Kotdnz/induction_anneal/media/images/cooling_fan.png

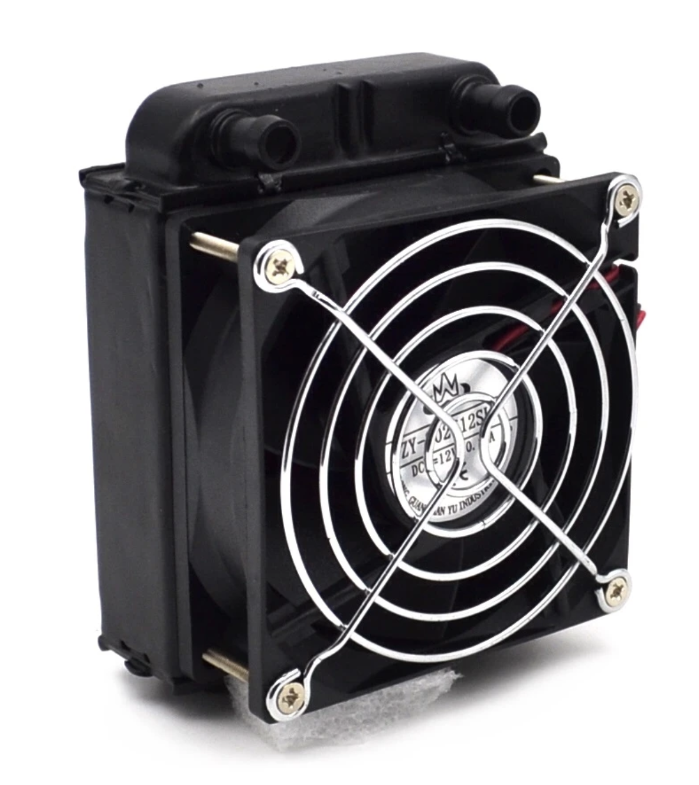
media/images/cooling_fan.png
