Kotdnz/induction_anneal/media/images/main_concept.jpg

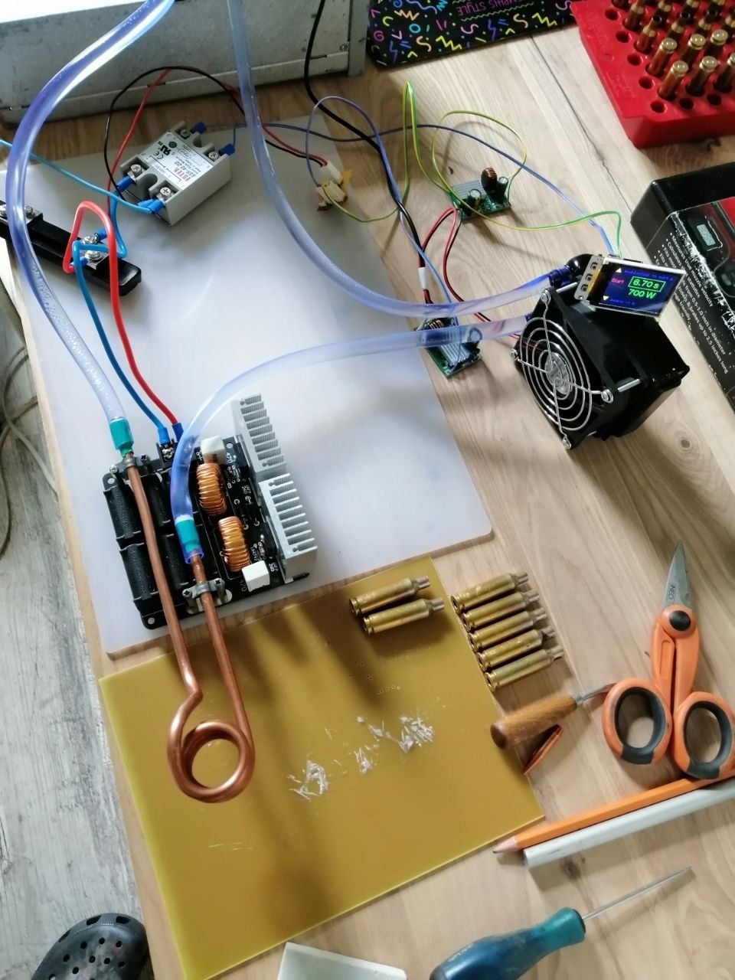
media/images/main_concept.jpg
