Kotdnz/induction_anneal/media/images/power_supply.jpg

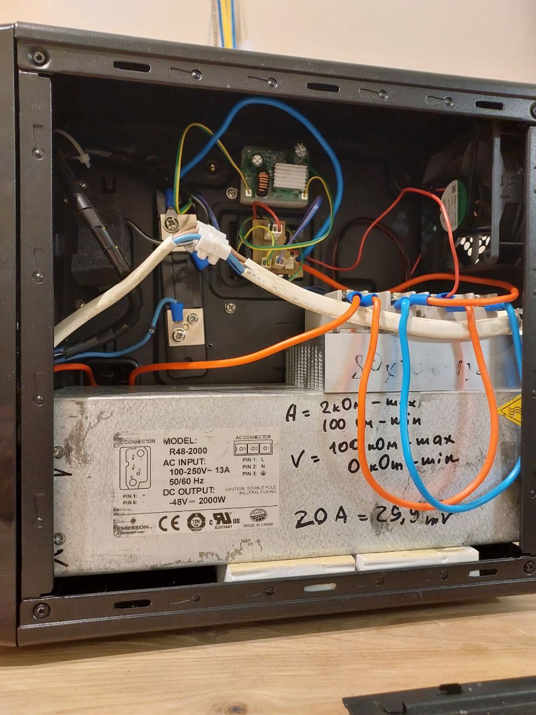
media/images/power_supply.jpg
