Kotdnz/induction_anneal/BOM.xlsx

 | кол-во | грн
Однофазне твердотільне реле SSR-40DD 40А DC-DC - сгорел! - беру 100а | 1 | 150 | https://prom.ua/ua/p1333096980-odnofaznoe-tverdotelnoe-rele.html?
ZVS 20A, 1000Вт вихровий індукційний нагрівач. Живлення 12-48В | 1 | 1000 | https://collider.prom.ua/ua/p884756762-zvs-20a-1000vt.html
Блок живлення Emerson R48-1800 з регулюванням 30-60В(35А) і вольтметром | 1 | 1150 | https://prom.ua/ua/p804608163-blok-pitaniya-emerson.html?
~~ Мікрокомп'ютер Raspberry Pi Pico~~ | ~~1~~ | ~~168~~ | ~~https://evo.net.ua/~~
~~Дисплей Raspberry Pi 1.3inch LCD 240x240 (14972)~~ | ~~1~~ | ~~392~~
Микросхема TSC103IDT | 1 | 62.71 | https://voron.ua/user_orders.php?id=412423
Шунт токовый FL-2 50A 75mV 0,5% | 1 | 62.71
Микросхема X9C103SZT1 | 1 | 45.61
 |  | 3031.03
